Tinotenda-K/asip-neural-processor/docs/img/control_fsm.png

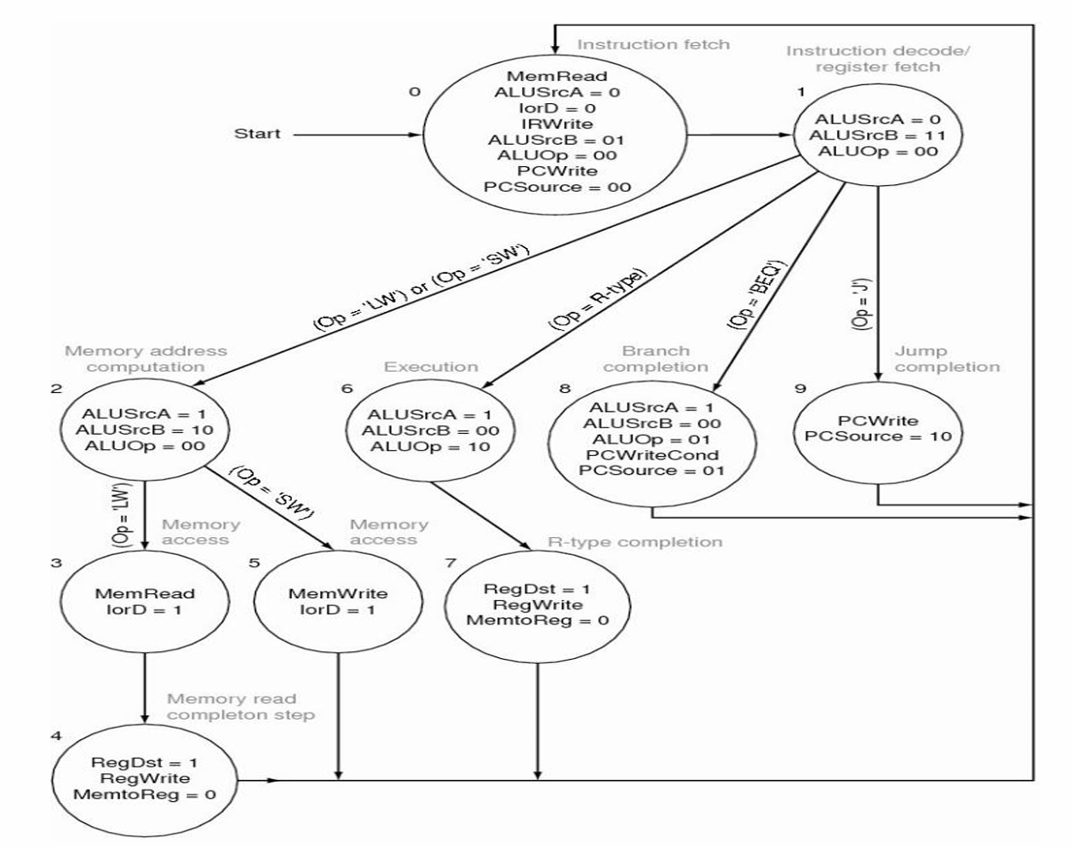
docs/img/control_fsm.png
