Tinotenda-K/asip-neural-processor/results/baseline_mac/Design Timing Summary baseline_mac.png

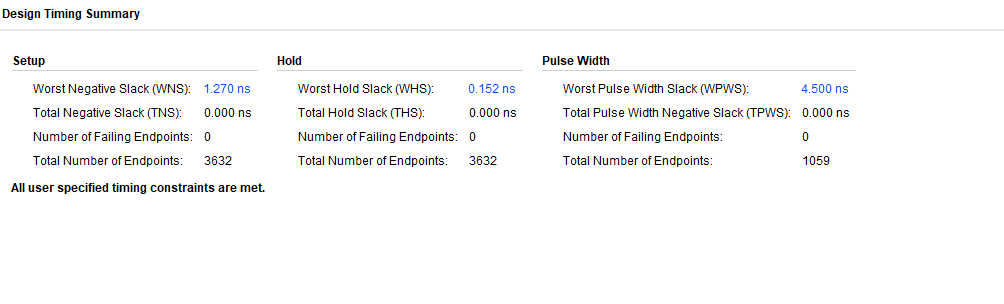
results/baseline_mac/Design Timing Summary baseline_mac.png
