Tinotenda-K/asip-neural-processor/results/mac4/Design Timing Summary.png

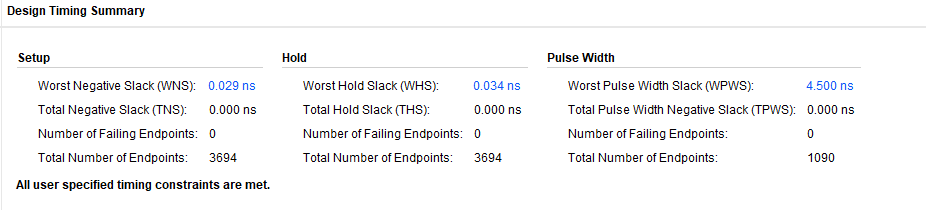
results/mac4/Design Timing Summary.png
