Tinotenda-K/asip-neural-processor/(commit log)

2026-08-19 Revise comments in TopModule for clarity and timing fixes
    Updated comments to clarify timing issues and design changes.
    [TopModule.v]
2026-08-19 Refactor ALU for parameterization and overflow fixes
    Updated ALU module to be parameterized and timing-aware, improving performance and fixing overflow bugs.
    [ALU.v]
2026-08-19 Fix comment formatting for reset signal in ProgramCounter
    [ProgramCounter.v]
2026-08-19 Fix comment formatting for expected result in tb_TopModule
    [tb_TopModule.v]
2026-08-19 Correct memory file names in comments
    Updated memory file names in comments for clarity.
    [tb_TopModule.v]
2026-08-20 Revise debugging details for memory and opcode handling
    Updated memory declaration and control flow diagnosis in debugging documentation.
2026-08-20 Revise quantisation documentation and pipeline flow
    Updated quantisation details, including weight sizes and packing information. Clarified the flow of the pipeline and the role of dnn_parameters_final.txt.
